phkahler/mellori_ITX/images/mellori_back.JPG

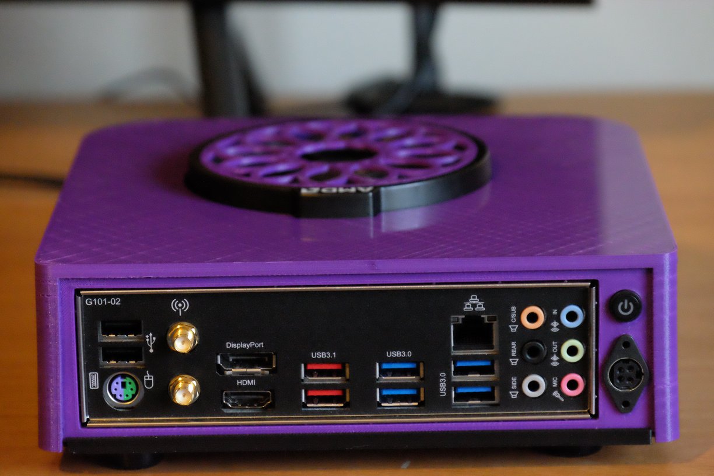
images/mellori_back.JPG
