phkahler/mellori_ITX/STL/fastener_test.stl

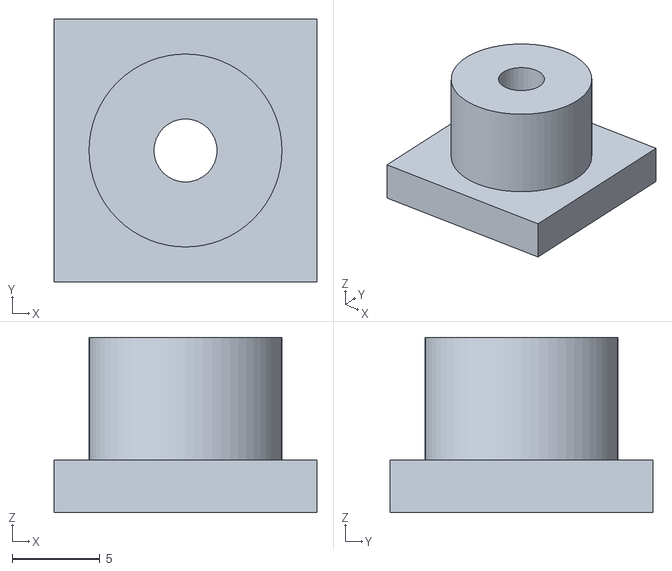
[picture p3: CAD file, 2018-12-01]
STL/fastener_test.stl
15.0 x 15.0 x 10.0
