phkahler/mellori_ITX/STL/ITX_back.stl

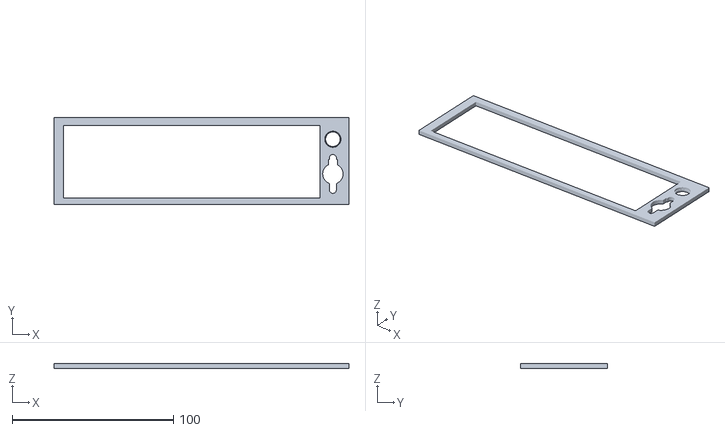
[picture p4: CAD file, 2018-12-01]
STL/ITX_back.stl
183.0 x 54.0 x 2.80
