phkahler/mellori_ITX/STL/ITX_bottom.stl

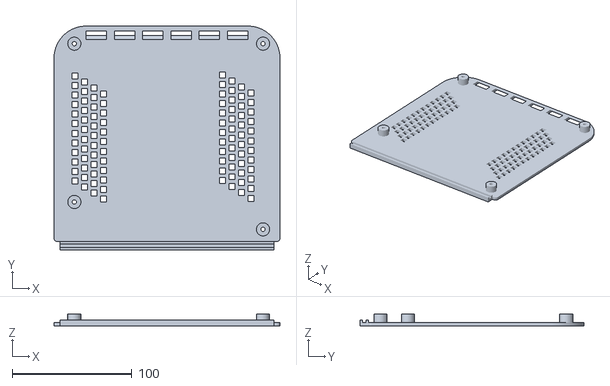
[picture p5: CAD file, 2018-12-01]
STL/ITX_bottom.stl
188.6 x 186.8 x 10.0
