phkahler/mellori_ITX/STL/Wraith_Stealth_Grill.stl

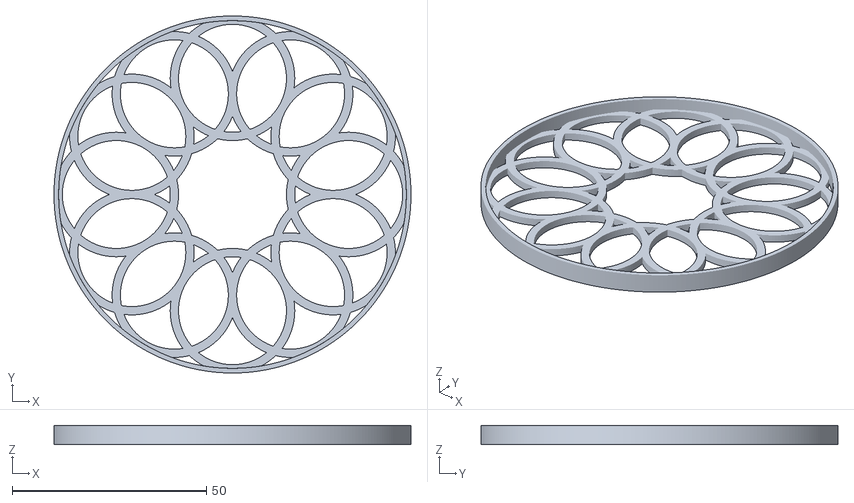
[picture p6: CAD file, 2018-12-01]
STL/Wraith_Stealth_Grill.stl
92.0 x 92.0 x 5.00
