phkahler/mellori_ITX/STL/ITX_top.stl

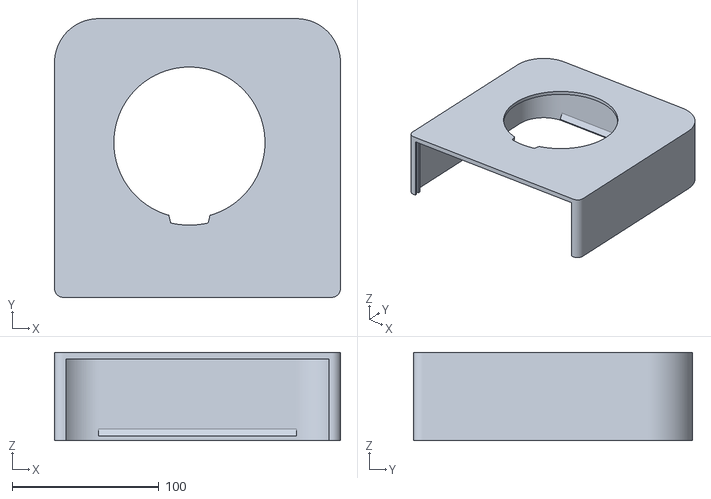
[picture p7: CAD file, 2018-12-01]
STL/ITX_top.stl
195.0 x 190.0 x 60.0
