phkahler/mellori_ITX/(threads)

Thread 1 (2019-05-16):

Looking for a new board.

phkahler, 2019-05-16:
For the next revision of this box I'd like to use another motherboard. I'm leaning toward the B450 I AORUS. It has 2 HDMI ports, and if I'm not mistaken can drive 4K at 60Hz - I only get 30 now, but not sure where the limitation is. They've also moved the M.2 slot to the top side, which means the standoffs could be reduced by a few mm. Also looks like 8 LEDs across the front.

I'm open to other suggestions that improve cost, size, capability, or aesthetics.

Thread 2 (2019-05-16):

USB ports on top

phkahler, 2019-05-16:
Design a crescent shaped insert that fits around the fan shroud to provide USB ports on top. Obviously this would be more accessible than the back, and the PC won't be pushed around the desk when plugging in storage devices.
